luiszorzi/estacao_automatica_pets/(commit log)

2026-06-06 Exemplo de horários
2026-06-22 feat: adicionada telemetria periódica e melhorei lógica de alimentação
